danshardware/RadioPixelHardware/RadioPixelHardware.brd

## EAGLE design RadioPixelHardware.brd (2015-11-22)

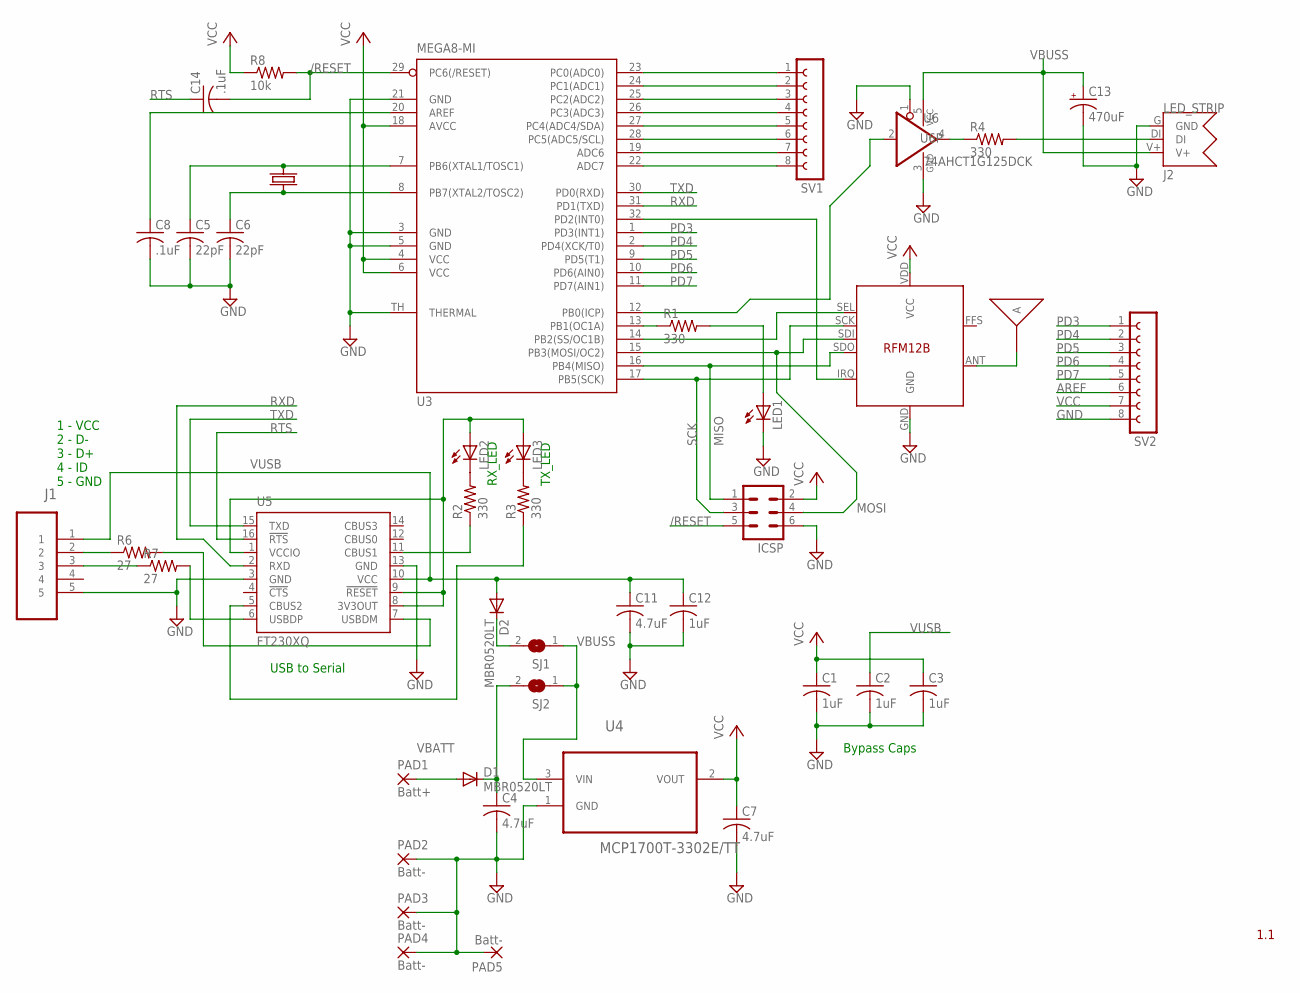
[picture p1: schematic RadioPixelHardware.sch]

Parts:
C1, C2, C3, C12: 1uF; C0603
C4, C7, C11: 4.7uF; C0603
C5, C6: 22pF; C0603
C8, C14: .1uF; C0603
C13: 470uF; TT2D4L
D1, D2: MBR0520LT; SOD123
ICSP: MA03-2
J1: 47346-0001; MOLEX_47346-0001
J2: LED_STRIP; LEDSTRIP_HEAD
LED1, LED2, LED3: LEDSML0603; SML0603
PAD1: Batt+; 1,6/0,8
PAD2, PAD3, PAD4, PAD5: Batt-; 1,6/0,8
R1, R2, R3, R4: 330; R0603
R6, R7: 27; R0603
R8: 10k; R0603
SJ1, SJ2: SJ
SV1, SV2: FE08-1; FE08
U2: RFM12B
U3: MEGA8-MI; MLF32-TH
U4: MCP1700T-3302E/TT; SOT95P237X112-3N
U5: FT230XQ; QFN16
U6: 74AHCT1G125DCK; SC70-5
U$2: ANTANT-PCB-868MHZ; ANT-900MHZ-60DBM
X1: CRYSTAL3.2MMX2.5MM; XTAL-SMD-3.2X2.5

Connections:
/RESET: C14.2, ICSP.5, R8.2, U3.29 (PC6(/RESET))
AREF: C8.1, SV2.6, U3.20 (AREF)
GND: C1.2, C2.2, C3.2, C4.2, C5.2, C6.2, C7.2, C8.2, C11.2, C12.2, C13.-, ICSP.6, J1.5, J2.G (GND), LED1.C, PAD2.1, PAD3.1, PAD4.1, PAD5.1, SV2.8, U2.GND, U3.3 (GND), U3.5 (GND), U3.21 (GND), U3.TH (THERMAL), U4.1 (GND), U5.3 (GND), U5.13 (GND), U6.1 (OE), U6.3 (GND)
MISO: ICSP.1, U2.SDO, U3.16 (PB4(MISO))
MOSI: ICSP.4, U2.SDI, U3.15 (PB3(MOSI/OC2))
unnamed: U2.SEL, U3.14 (PB2(SS/OC1B))
unnamed: U2.IRQ, U3.32 (PD2(INT0))
unnamed: U2.ANT, U$2.P$1
unnamed: R1.1, U3.13 (PB1(OC1A))
unnamed: LED1.A, R1.2
unnamed: R4.1, U6.4 (O)
unnamed: R2.1, U5.11 (CBUS1)
unnamed: U3.12 (PB0(ICP)), U6.2 (I)
unnamed: R7.2, U5.6 (USBDP)
unnamed: R6.2, U5.7 (USBDM)
unnamed: C4.1, D1.C, SJ2.2
unnamed: LED2.C, R2.2
unnamed: LED3.C, R3.2
unnamed: J1.2, R6.1
unnamed: R3.1, U5.5 (CBUS2)
unnamed: C5.1, U3.7 (PB6(XTAL1/TOSC1)), X1.3 (2)
unnamed: D2.C, SJ1.2
unnamed: C6.1, U3.8 (PB7(XTAL2/TOSC2)), X1.1
unnamed: J1.3, R7.1
unnamed: SV1.1, U3.23 (PC0(ADC0))
unnamed: SV1.2, U3.24 (PC1(ADC1))
unnamed: SV1.3, U3.25 (PC2(ADC2))
unnamed: SV1.4, U3.26 (PC3(ADC3))
unnamed: SV1.5, U3.27 (PC4(ADC4/SDA))
unnamed: SV1.6, U3.28 (PC5(ADC5/SCL))
unnamed: SV1.7, U3.19 (ADC6)
unnamed: SV1.8, U3.22 (ADC7)
unnamed: J2.DI, R4.2
PD3: SV2.1, U3.1 (PD3(INT1))
PD4: SV2.2, U3.2 (PD4(XCK/T0))
PD5: SV2.3, U3.9 (PD5(T1))
PD6: SV2.4, U3.10 (PD6(AIN0))
PD7: SV2.5, U3.11 (PD7(AIN1))
RTS: C14.1, U5.16 (!RTS)
RXD: U3.31 (PD1(TXD)), U5.2 (RXD)
SCK: ICSP.3, U2.SCK, U3.17 (PB5(SCK))
TXD: U3.30 (PD0(RXD)), U5.15 (TXD)
USB3V3: LED2.A, LED3.A, U5.1 (VCCIO), U5.8 (3V3OUT), U5.9 (!RESET)
VBATT: D1.A, PAD1.1
VBUSS: C13.+, J2.V+, SJ1.1, SJ2.1, U4.3 (VIN), U6.5 (VCC)
VCC: C1.1, C3.1, C7.1, ICSP.2, R8.1, SV2.7, U2.VDD (VCC), U3.4 (VCC), U3.6 (VCC), U3.18 (AVCC), U4.2 (VOUT)
VUSB: C2.1, C11.1, C12.1, D2.A, J1.1, U5.10 (VCC)

Notes on the sheet:
Bypass Caps
1 - VCC 2 - D- 3 - D+ 4 - ID 5 - GND
USB to Serial
RX_LED
TX_LED
1.1

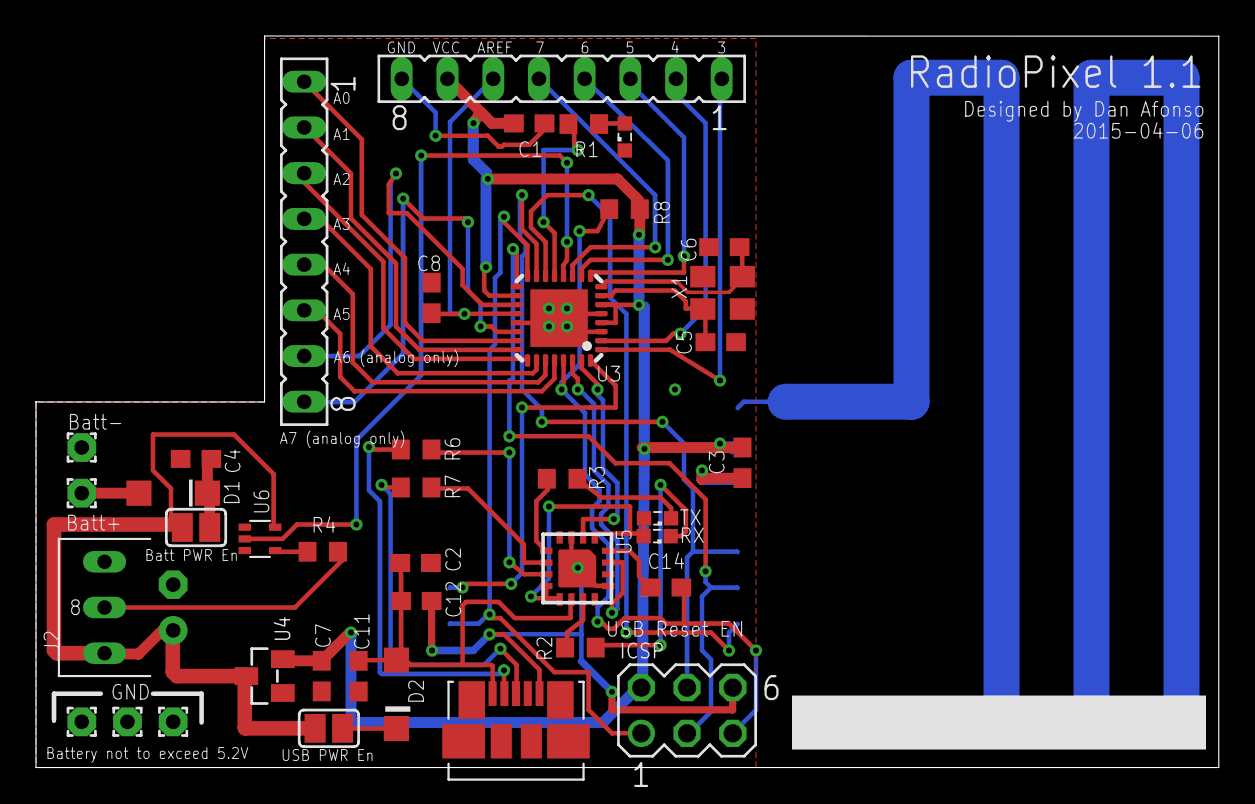
[picture p2: board RadioPixelHardware.brd from above]

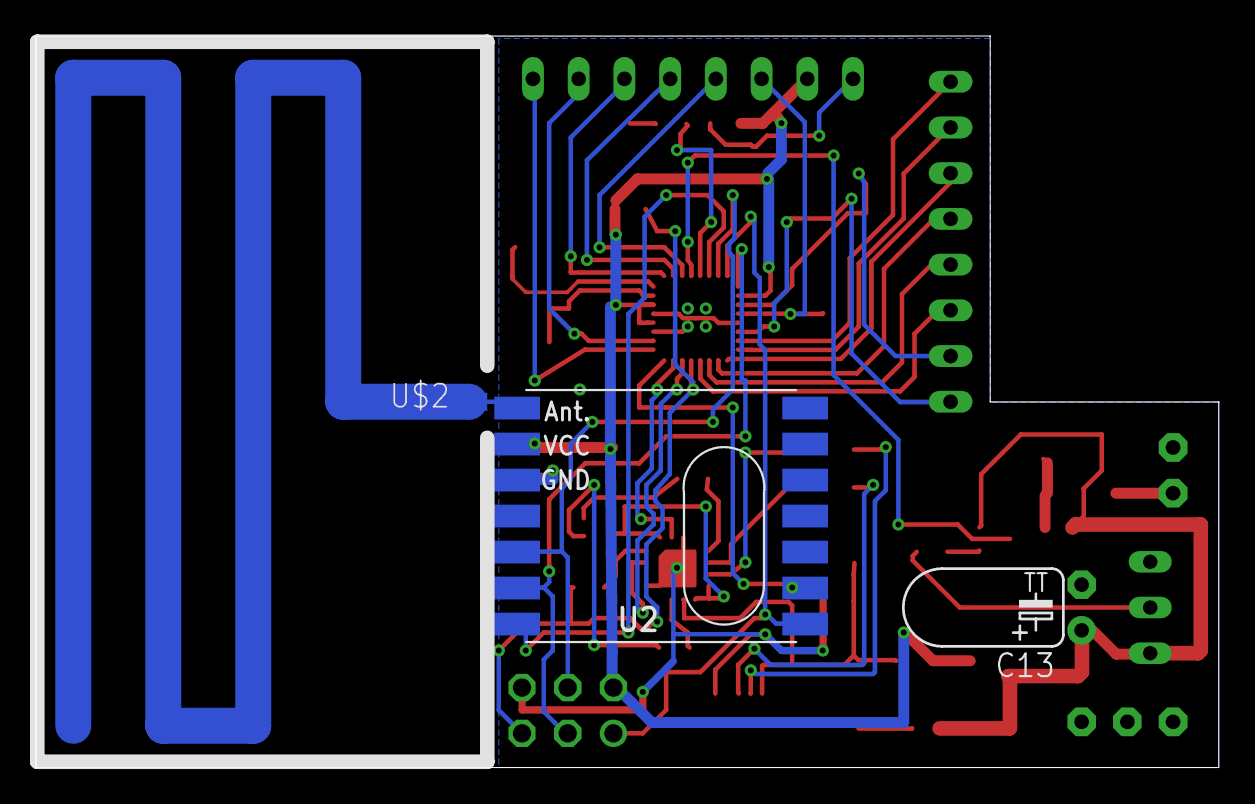
[picture p3: board RadioPixelHardware.brd from below]

Board: 2 copper layers, 65.7 x 40.6 mm, 43 parts (3 on the bottom side), 47 nets.
