danshardware/RadioPixelHardware/Radio Pixel Assembly.docx

# Radio Pixel 1.1 Assembly

| 1uF C1, C2, C3, C8, C14
| 4.7uF C4, C7
| 22pF C5, C6
| Schottky Diode D1, D2 K-mark on silk

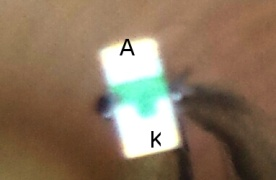
[picture p4: figure]
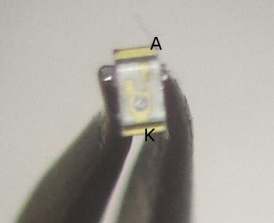
[picture p5: figure]

| Blue LED K-mark:
| Green LED K-mark:
| Red LED K-mark:
| 330 Ohm R1-4
| 27 Ohm R6. R7
| 10K Ohm R8
| MCP1700 U4
| 74AHCT1G125 U6
| Crystal

Do NOT populate the RF circuit until after programming as it will screw up the ICSP

# Programing

1. Start the programmer and set the clock speed to 250KHz
2. Read the device ID to make sure we can talk to the uC
3. Set the fuse bits to HI: DC Lo: DE, EXT: FD
